JuliaSteiwer/IoT-Water-Quality-Monitoring/Images/Node/Inside/DSC_0520-min.JPG

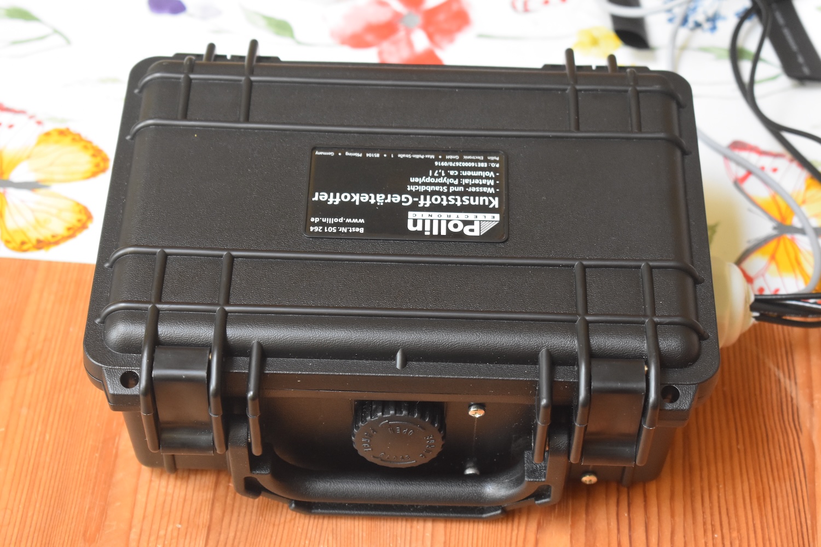
Images/Node/Inside/DSC_0520-min.JPG
