JuliaSteiwer/IoT-Water-Quality-Monitoring/Images/Node/Inside/DSC_0521-min.JPG

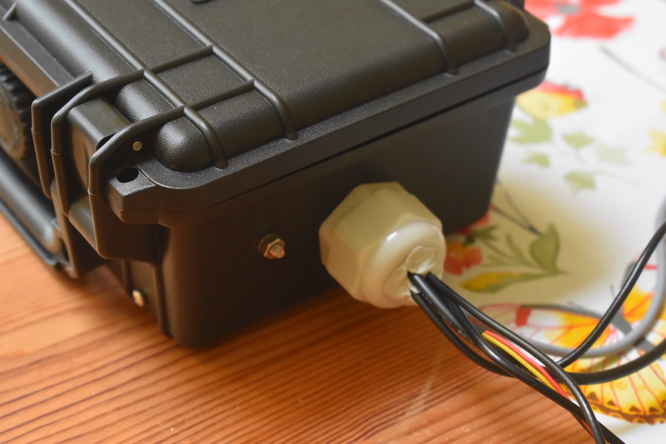
Images/Node/Inside/DSC_0521-min.JPG
