JuliaSteiwer/IoT-Water-Quality-Monitoring/Sensors/suite.md

<h1>Sensor Suite</h1>
<ul>
  <li>Dissolved Oxygen (DO): <a href="https://www.dfrobot.com/product-1628.html">SKU: SEN0237-A</a> by DFRobot</li>
  <li>Electrical Conductivity (EC): <a href="https://www.dfrobot.com/product-1123.html">SKU: DFR0300</a> by DFRobot</li>
  <li>pH value: <a href="https://www.dfrobot.com/product-1025.html">SKU: SEN0161</a> by DFRobot</li>
  <li>Temperature: <a href="https://www.sensorshop24.de/temperaturfuehler-passiv/kabelfuehler-durchmesser-6mm">DS18B20</a> by SensorShop24 or <a href="https://www.dfrobot.com/product-1354.html">SKU: KIT0021</a> by DFRobot</li>
  <li>Total Dissolved Solids (TDS): <a href="https://www.dfrobot.com/product-1662.html">SKU: SEN0244</a> by DFRobot</li>
  <li>Turbidity: <a href="https://www.dfrobot.com/product-1394.html">SKU: SEN0189</a> by DFRobot</li>
</ul>
