JuliaSteiwer/IoT-Water-Quality-Monitoring/Publications/2024-06-26-ICT4S_Poster.pdf

Sustainable Communication
Networks

Faculty 1: Physics / Electrical Engineering
Research Group Prof. Dr. Förster

# IoT-based Anomaly Detection for Identifying Point Sources of Water Pollution

Julia Steiwer
jsteiwer@uni-bremen.de
Bremen 10. 06.2024

## Motivation

- Human right to water and sanitation.
- Agenda 2030: 17 Sustainable Development Goals.
- 2 billion people globally without access to clean water and proper sanitation.
- 1 million deaths per year to preventable diarrhea alone.

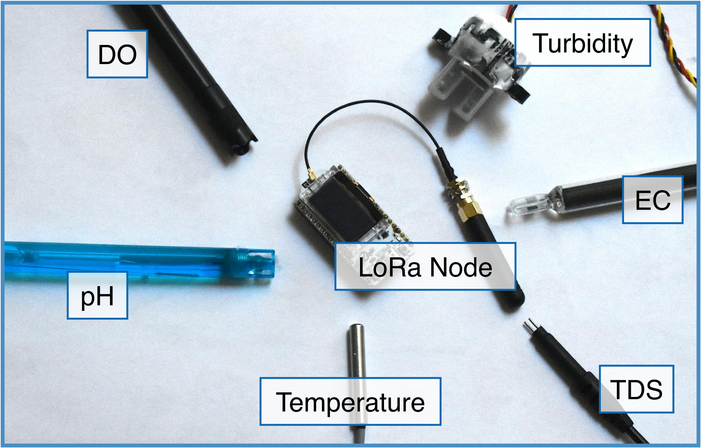
[picture p3: figure]
Temperature; Turbidity DO; LoRa Node; TDS
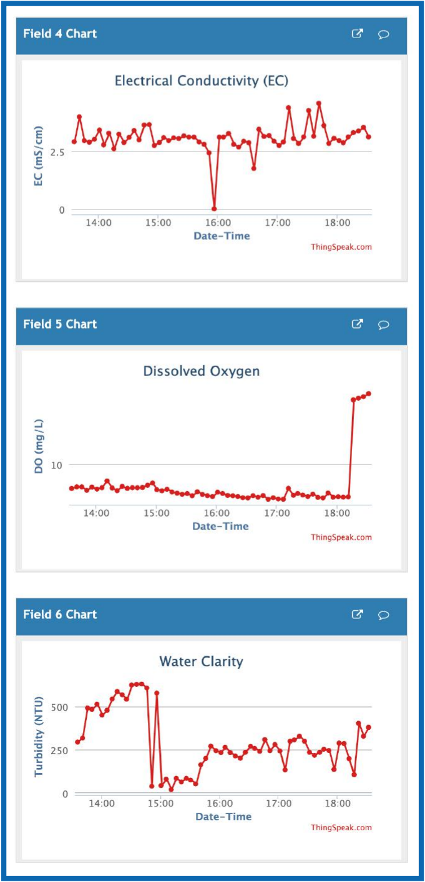
[picture p4: figure]

## First Prototype

- LoRaWAN to
TheThingsNetwork (TTN).
- ThingSpeak for
visualization.
- Deep sleep during
inactivity.
- Solar panel.

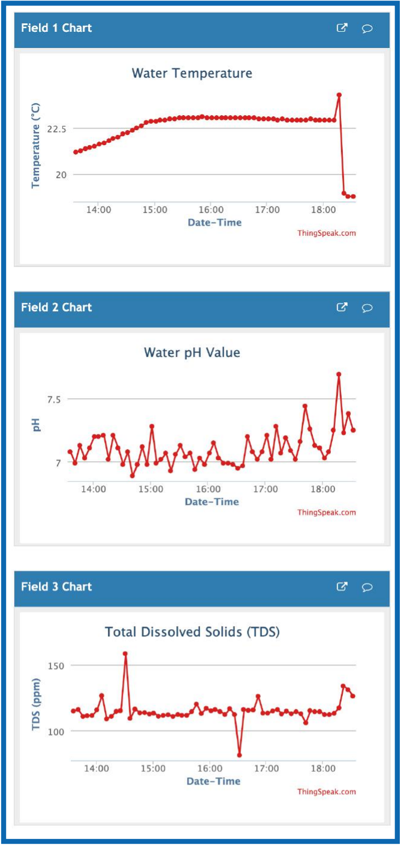
[picture p5: figure]
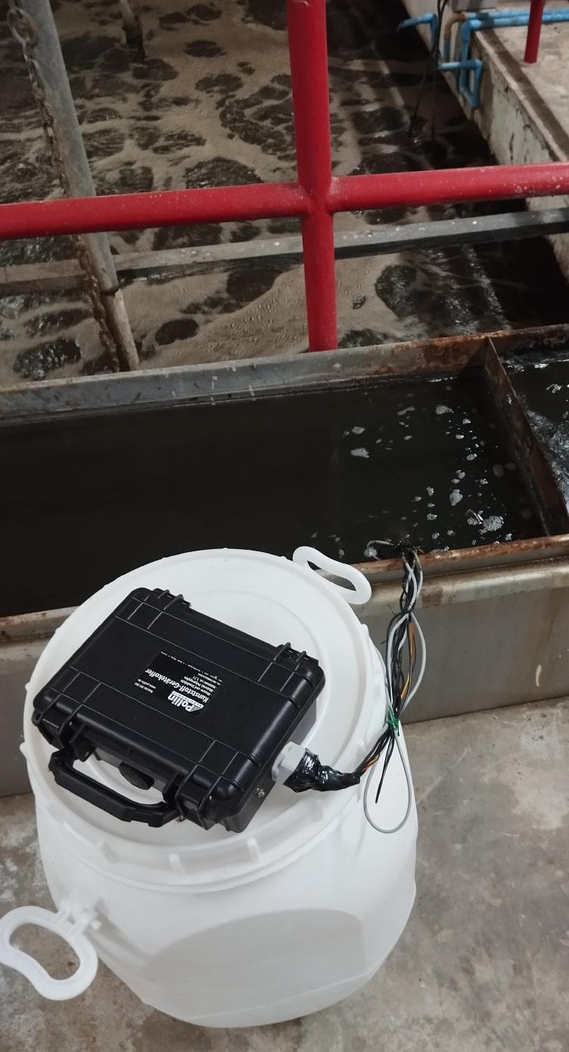
[picture p6: figure]
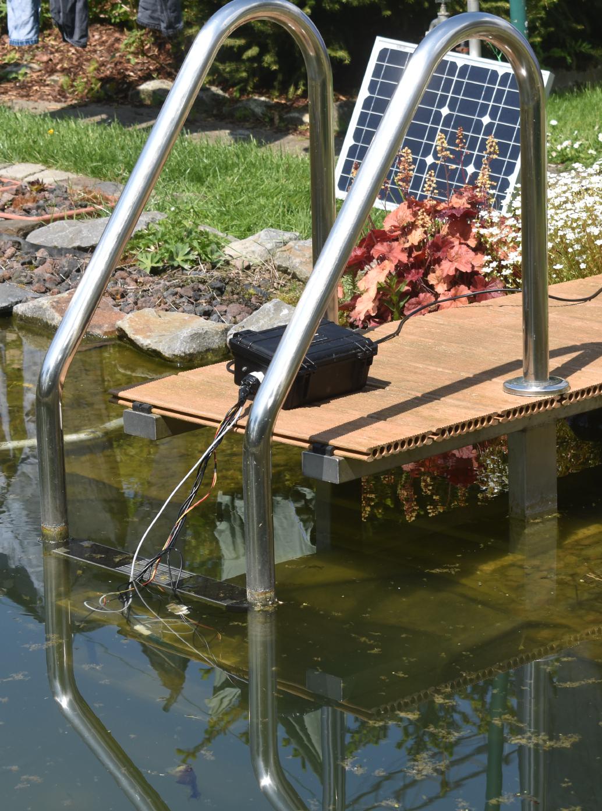
[picture p7: figure]

## Next Steps | Ongoing Research

- Expand sensor suite: BOD/COD, phosphate, nitrate/ammonia, pathogens (e.g. E. coli, Legionella).
- Monitor external factors to assess environmental conditions, e.g. flow rate, solar irradiance, rainfall.
- Microbial fuel cell (MFC) as sensor (microbial activity, BOD/COD).
- Increase system resilience: monitor individual sensors (S. Attarha), monitor battery state and adapt actions (WoCA, FAU Erlangen), monitor communication (S. Band).
- Integrate remote sensing approaches (satellites, webcams) to monitor large-scale pollution.
- Use image and sensor data to train prediction and anomaly detection models; predict, identify and localize pollution events.
- Create a (web) app to use as a warning system and to make findings available.

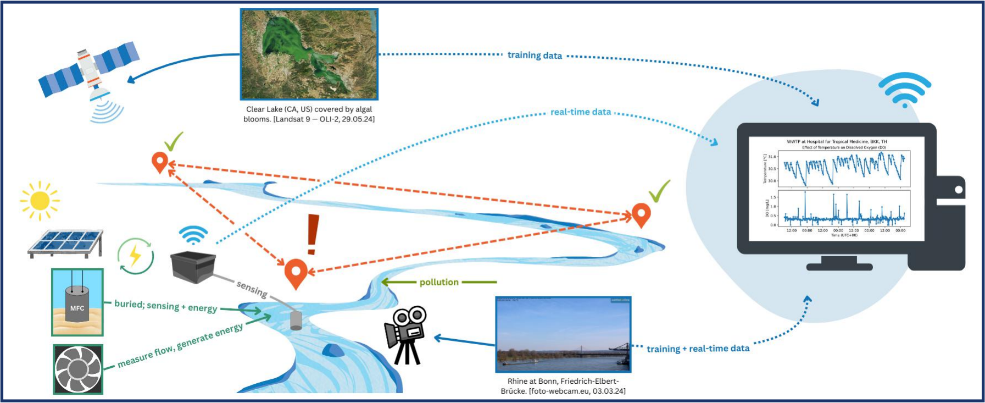
[picture p8: figure]

References

- B. M. Thobor, F. R. Schanz, A. Förster, S. Kerzenmacher, C. Wild, Microbial fuel cells in coral reef sediments as indicator tools for organic carbon eutrophication, Ecological Indicators 153 (2023) 110385. URL: https://linkinghub.elsevier.com/retrieve/pii/S1470160X23005277. doi: 10.1016/j.ecolind.2023.110385.
- J. Huang, D. Han and A. J. Steckl, "Flow-Cell Sensor for Bacteria Detection Using Gate-Modified Organic Electrochemical Transistor," in IEEE Sensors Journal, vol. 24, no. 5, pp. 5797-5805, 1 March1, 2024, doi: 10.1109/JSEN.2024.3350969.
- Phillip Raffeck, Johannes Maier, and Peter Wägemann. 2024. WoCA: Avoiding Intermittent Execution in Embedded Systems by Worst- Case Analyses with Device States. In Proceedings of the 25th ACM SIGPLAN/SIGBED International Conference on Languages, Compil- ers, and Tools for Embedded Systems (LCTES ’24), June 24, 2024, Copenhagen, Denmark. ACM, New York, NY, USA, 12 pages. https: //doi.org/10.1145/3652032.3657569
