JuliaSteiwer/IoT-Water-Quality-Monitoring/Images/Node/Inside/DSC_0523-min.JPG

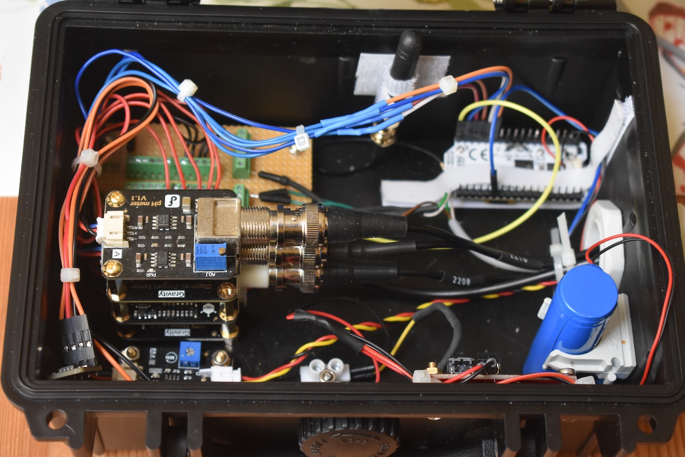
Images/Node/Inside/DSC_0523-min.JPG
