JuliaSteiwer/IoT-Water-Quality-Monitoring/Schematic/waterQuality_sensorNode.GIF

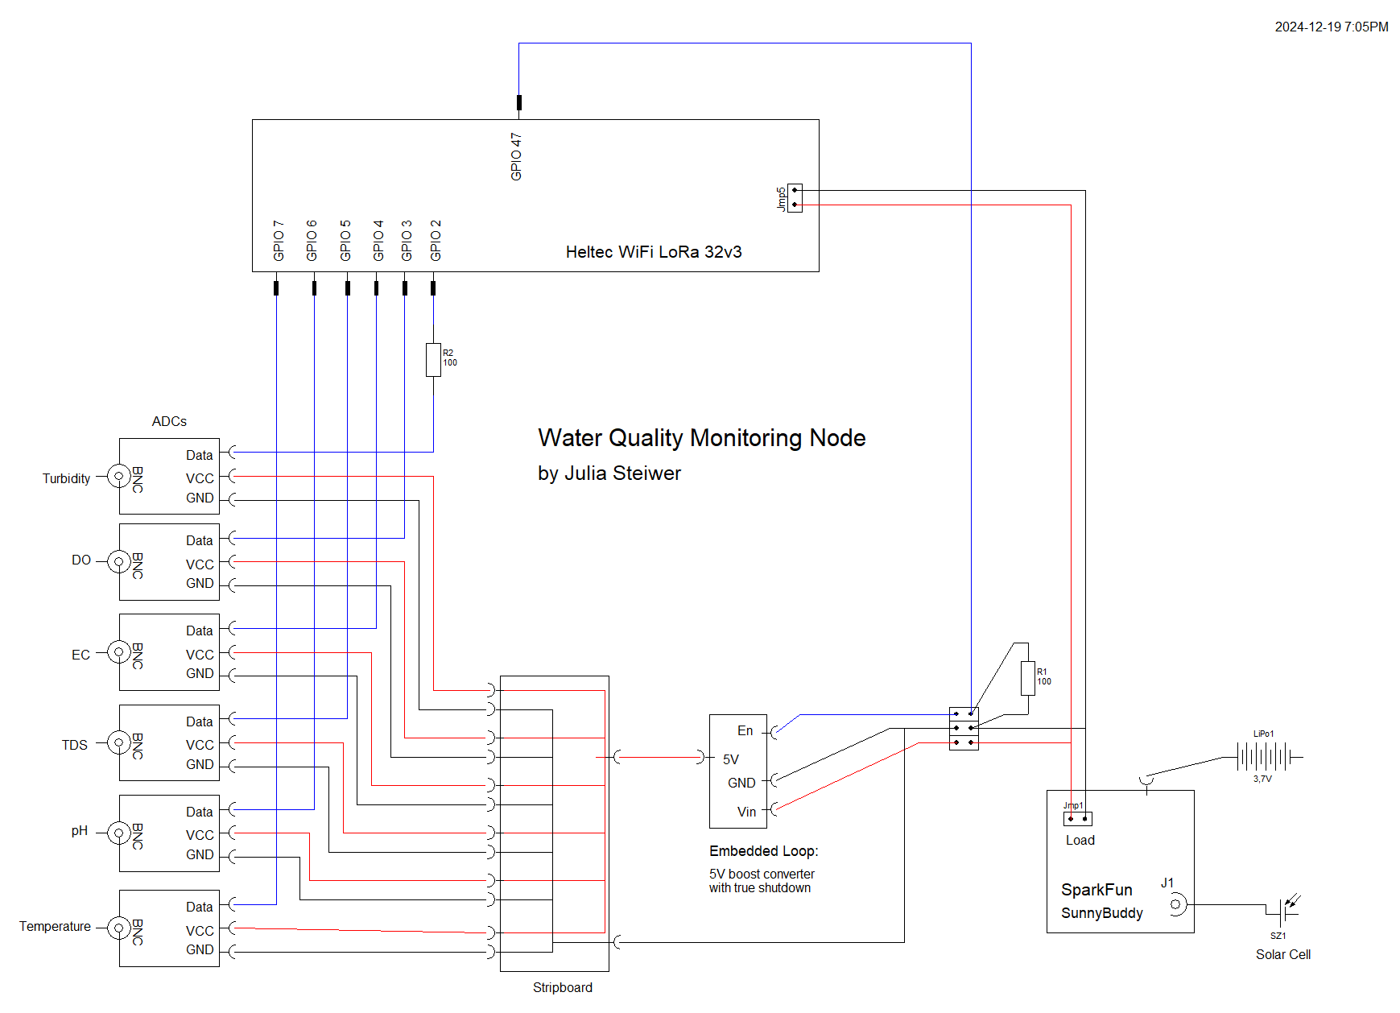
Schematic/waterQuality_sensorNode.GIF
