JuliaSteiwer/IoT-Water-Quality-Monitoring/(commit log)

2024-01-20 Create DFRobot_pHSensorV1.ino
    Code for the pH sensor (meter v1 from DFRobot).
2024-01-20 Create DFRobot_DO_sensor_calibrate.ino
    Calibration code for the dissolved oxygen sensor (SEN0237) by DFRobot.
2024-01-20 Create DFRobot_DO_sensor_measure.ino
    Code to measure dissolved oxygen (DO) with the SEN0237 sensor by DFRobot.
2024-01-27 Update test_27Jan2024_1845.ino
    Gather temperature data via sensor. Sensor is plugged to the programmable Ve pin using Vext, which has 3.3V when active and 0V when in deep sleep. Data is sent once every minute to TheThingsNetwork (TTN).
2024-01-27 Get data from DS18B20 temperature sensor.
2024-01-27 Combine programmable Ve pins with temperature sensor data.
2024-01-27 Ve pins + temperature sensor data; irregular sending.
2024-01-27 Send data from pH and ttemperature sensors. No Vext.
2024-01-27 Send data from pH and temperature sensor.
2024-01-28 Added TDS sensor; works correctly.
    [test_28Jan2024_1229.ino]
2024-01-28 Added EC sensor; works correctly.
    [test_28Jan2024_1323.ino]
2024-01-28 Added DO sensor; works correctly.
    DO = dissolved oxygen
    [test_28Jan2024_1520.ino]
2024-01-28 Added turbidity sensor; works correctly.
    [test_28Jan2024_1539.ino]
2024-01-28 Full sensor suite; send data every hour.
2024-02-04 Turn LED on when awake; LED is on during deep sleep
2024-02-09 Sensors are off during deep sleep.
2024-02-10 Works (no-rejoins, correct data, sensors off during sleep).
2024-02-14 Current working code.
2024-02-14 LoRaWAN End Device (by Steven Boonstoppel)
